paramsaini87/RISCV_8_stage/(commit log)

2026-05-09 Initial commit: RV32IMAC 8-stage pipelined CPU
    Pipeline: IF1 -> IF2 -> ID -> RR -> EX1 -> EX2 -> MEM -> WB
    ISA: RV32IMAC (82 instructions)
    Target: SKY130 130nm PDK, 80-120 MHz
2026-05-14 RUN 23: rv32i 8-stage synthesis — 169,132 SKY130 cells, WNS +9.043ns
    - SMART-5C Phase 5c: 4.2h runtime → ~3s (5040x speedup)
    - Cells: 169,132 sky130_fd_sc_hd (identical to RUN 22)
    - WNS: +9.043ns (setup clean), Hold: 13,001 violations (PnR will fix)
    - Phase 5f retiming: sequential timing corrections applied
    [rv32i_cpu.v]
2026-05-18 Add full RTL-to-GDS signoff outputs — MY FLOW RUN_2026-05-17
    - Magic DRC: 0 violations
    - KLayout DRC: 0 violations
    - LVS: circuits match uniquely (242,823 devices)
    - Hold timing: all 9 corners pass
    - Includes: GDS, DEF, SPEF(max), SDF(TT+FF), LIB, NL, PNL, SPICE, reports, 7 PnR images
    [metrics.csv, rv32i_cpu__max_ff_n40C_1v95.sdf, rv32i_cpu__max_tt_025C_1v80.sdf, rv32i_cpu__min_ff_n40C_1v95.sdf, rv32i_cpu__min_tt_025C_1v80.sdf, rv32i_cpu__nom_ff_n40C_1v95.sdf, rv32i_cpu__nom_tt_025C_1v80.sdf]
2026-05-18 Add full RTL-to-GDS signoff outputs — MY FLOW RUN_2026-05-17
    - Includes: GDS, DEF, SPEF(max), SDF(TT+FF x6), LIB(x9), NL, PNL, SPICE, reports, 7 PnR images
    - README: complete RTL-to-GDS documentation (17 sections)
    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
